lukematheny/BikeProject/(commit log)

2024-08-27 Adding all Kicad files
    [USBPD-2.kicad_pcb, USBPD-2.kicad_sch, planning.xlsx]
2024-09-03 removed excel for conflicts
    [planning.xlsx]
2024-09-03 Modularized kicad schematic
    [USBPD-2.kicad_sch]
2024-11-11 11/11 changes
    [USBPD-2.kicad_sch]
